jackbackrack/socialbadge-ai/designs/socialbadge_ai.designs.badge_main.BadgeDesign/kicad/3d-models/jitx-64d1493ab789d8dc4b7b3f0a.stp

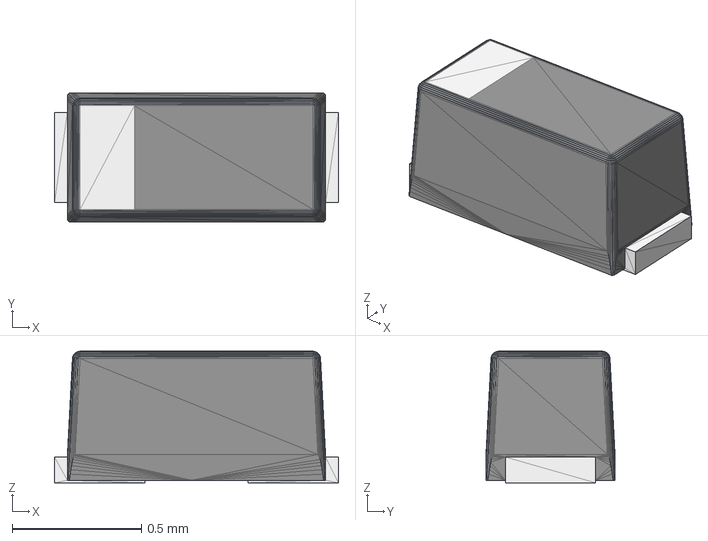
[picture p1: CAD file, 2026-09-09, last stored version]
designs/socialbadge_ai.designs.badge_main.BadgeDesign/kicad/3d-models/jitx-64d1493ab789d8dc4b7b3f0a.stp
1.10 x 0.5 x 0.51 mm
