jackbackrack/socialbadge-ai/designs/socialbadge_ai.designs.badge_main.BadgeDesign/kicad/3d-models/jitx-64d13eb0b789d8dc4b79e9c7.stp

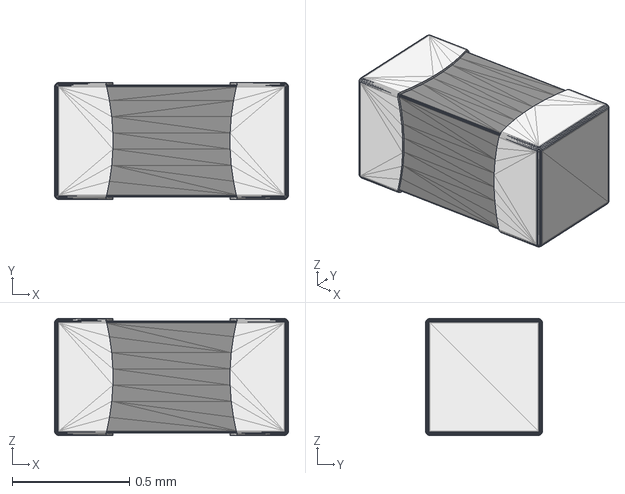
[picture p2: CAD file, 2026-09-09, last stored version]
designs/socialbadge_ai.designs.badge_main.BadgeDesign/kicad/3d-models/jitx-64d13eb0b789d8dc4b79e9c7.stp
1.00 x 0.5 x 0.5 mm
