jackbackrack/socialbadge-ai/designs/socialbadge_ai.designs.badge_main.BadgeDesign/kicad/socialbadge_ai.designs.badge_main.BadgeDesign.kicad_pcb

## KiCad design designs/socialbadge_ai.designs.badge_main.BadgeDesign/kicad/socialbadge_ai.designs.badge_main.BadgeDesign.kicad_pcb (2026-09-11, last stored version)

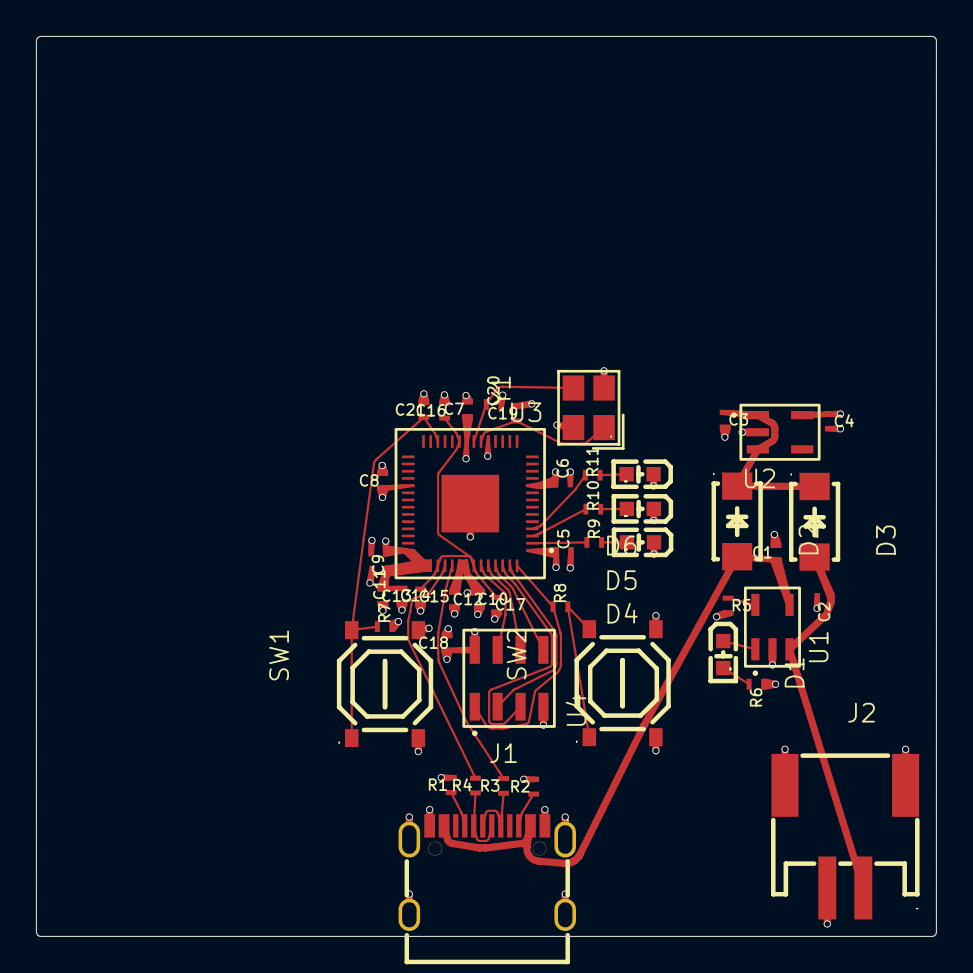
[picture p3: board socialbadge_ai.designs.badge_main.BadgeDesign.kicad_pcb from above]

Board: 4 copper layers, 50.0 x 50.0 mm, 47 parts (0 on the bottom side), 31 nets.

Parts:
C1: 4.7 µF; LANDPATTERN0402_4
C2: 4.7 µF; LANDPATTERN0402_5
C3: 1 µF; LANDPATTERN0402_8
C4: 1 µF; LANDPATTERN0402_9
C5: 100 nF; LANDPATTERN0402_10
C6: 100 nF; LANDPATTERN0402_11
C7: 100 nF; LANDPATTERN0402_12
C8: 100 nF; LANDPATTERN0402_13
C9: 100 nF; LANDPATTERN0402_14
C10: 100 nF; LANDPATTERN0402_15
C11: 100 nF; LANDPATTERN0402_16
C12: 100 nF; LANDPATTERN0402_17
C13: 1 µF; LANDPATTERN0402_18
C14: 100 nF; LANDPATTERN0402_19
C15: 1 µF; LANDPATTERN0402_20
C16: 100 nF; LANDPATTERN0402_21
C17: 100 nF; LANDPATTERN0402_22
C18: 100 nF; LANDPATTERN0402_23
C19: 27 pF; LANDPATTERN0402_24
C20: 27 pF; LANDPATTERN0402_25
C21: 100 nF; LANDPATTERN0402_27
D1: KT-0603R; Pkg_LP_1
D2: SS14; Pkg_LP_2
D3: SS14; Pkg_LP_3
D4: KT-0603R; Pkg_LP_7
D5: KT-0603R; Pkg_LP_8
D6: KT-0603R; Pkg_LP_9
J1: TYPE-C-31-M-12; Pkg_LP
J2: 2.0-2P WT; Pkg_LP_10
R1: 5.1 kΩ; LANDPATTERN0402
R2: 5.1 kΩ; LANDPATTERN0402_1
R3: 27 Ω; LANDPATTERN0402_2
R4: 27 Ω; LANDPATTERN0402_3
R5: 2 kΩ; LANDPATTERN0402_6
R6: 1 kΩ; LANDPATTERN0402_7
R7: 10 kΩ; LANDPATTERN0402_26
R8: 1 kΩ; LANDPATTERN0402_28
R9: 330 Ω; LANDPATTERN0402_29
R10: 330 Ω; LANDPATTERN0402_30
R11: 330 Ω; LANDPATTERN0402_31
SW1: TS-1187A-B-A-B; Pkg_LP_5
SW2: TS-1187A-B-A-B; Pkg_LP_6
U1: MCP73831T-2ACI/OT; SOT23_5
U2: AP2112K-3.3TRG1; SOT23_5_1
U3: RP2040; QFN
U4: W25Q128JVSIQ; SOIC
Y1: X322512MSB4SI; Pkg_LP_4

Connections:
1V1: C15.1, C16.1, C17.1, U3.23, U3.45, U3.50
3V3: C4.1, C5.1, C6.1, C7.1, C8.1, C9.1, C10.1, C11.1, C12.1, C13.1, C14.1, C18.1, R6.1, R7.2, U2.5, U3.1, U3.10, U3.22, U3.33, U3.42, U3.43, U3.44, U3.48, U3.49, U4.8
BOOTSEL_NODE: R8.2, SW2.1, SW2.2
CHG_STAT: D1.1, U1.1
GND: C1.2, C2.2, C3.2, C4.2, C5.2, C6.2, C7.2, C8.2, C9.2, C10.2, C11.2, C12.2, C13.2, C14.2, C15.2, C16.2, C17.2, C18.2, C19.2, C20.2, C21.2, D4.1, D5.1, D6.1, J1.9, J1.10, J1.13, J1.14, J1.15, J1.16, J2.2, J2.3, J2.4, R1.2, R2.2, R5.2, SW1.3, SW1.4, SW2.3, SW2.4, U1.2, U2.2, U3.19, U3.thermal_pads0, U4.4, Y1.2, Y1.3
GPIO[0]: R9.1, U3.2
GPIO[1]: R10.1, U3.3
GPIO[2]: R11.1, U3.4
PROG: R5.1, U1.5
QSPI_CSn: R8.1, U3.56, U4.1
QSPI_SCLK: U3.52, U4.6
QSPI_SD0: U3.53, U4.5
QSPI_SD1: U3.55, U4.2
QSPI_SD2: U3.54, U4.3
QSPI_SD3: U3.51, U4.7
RUN: C21.1, R7.1, SW1.1, SW1.2, U3.26
SYS: C3.1, D2.2, D3.2, U2.1, U2.3
USB_DM: R4.2, U3.46
USB_DN: J1.3, J1.5, R4.1
USB_DP: J1.4, J1.6, R3.1
VBAT: C2.1, D3.1, J2.1, U1.3
VBUS: C1.1, D2.1, J1.11, J1.12, U1.4
XIN: C19.1, U3.20, Y1.1
XOUT: C20.1, U3.21, Y1.4
mcu_USB_DP: R3.2, U3.47
p1: J1.8, R2.1
p2: D1.2, R6.2
r_cc1_p1: J1.2, R1.1
r_leds[0]_p2: D4.2, R9.2
r_leds[1]_p2: D5.2, R10.2
r_leds[2]_p2: D6.2, R11.2
