jackbackrack/socialbadge-ai/src/socialbadge_ai/designs/badge_main.py

"""
SocialBadge AI — top-level design.

40 × 40 mm square board with 0.25 mm rounded corners on the JLCPCB 4-layer FR-4
1080-prepreg stackup (JLC04161H_1080). Combines the USB-C interface, Li-ion
charger, Schottky power-path, 3.3 V LDO, and RP2040 support circuits into a
single buildable design.

Power tree (already documented in ARCHITECTURE.md):

  USB-C VBUS -+---[ SS14 ]--+
              |              SYS --[ AP2112K-3.3 ]--> 3V3 --> RP2040 + flash
              +--[ MCP73831 ]--> VBAT --[ SS14 ]--+
                                ^
                            JST-PH battery

Design rules and passive defaults are tuned for the JLCPCB Standard 4-layer fab class.
"""

import os

from jitx import Circuit, Design, Net, Pour
from jitx.board import Board
from jitx.constraints import (
    BinaryDesignConstraint,
    IsCopper,
    IsPad,
    IsTrace,
    Tag,
    UnaryDesignConstraint,
)
from jitx.shapes.composites import rectangle
from jitxlib.jlcpcb import JLC04161H_1080
from jitxlib.landpatterns.ipc import DensityLevel, DensityLevelContext
from jitxlib.parts import CapacitorQuery, Minimize, ResistorQuery
from jitxlib.symbols.net_symbols import GroundSymbol, PowerSymbol

from ..circuits.charger import Charger
from ..circuits.ldo_3v3 import LDO_3V3
from ..circuits.power_path import PowerPath
from ..circuits.rp2040_support import RP2040Support
from ..circuits.status_leds import N_LEDS, StatusLEDs
from ..circuits.usb_c import USB_C
from jitx_warp_integration.layout_placements import layout_placements

from ..components.connectors.shouhan_PH2_2P import PH2_2P

# Tags applied to nets so the design rules can match them by class.
class PowerTag(Tag):
    """Marks power rails for the wider-trace rule."""


class GroundTag(Tag):
    """Marks ground nets for the wider-trace rule."""


# Board outline — 40.0 × 40.0 mm with 0.25 mm rounded corners.
BOARD_SHAPE = rectangle(40.0, 40.0, radius=0.25)


class BadgeBoard(Board):
    """40.0 × 40.0 mm board with 0.25 mm rounded corners."""

    shape = BOARD_SHAPE


class BadgeCircuit(Circuit):
    """Top-level netlist for the badge.

    Instantiates all five subcircuits, wires up the power tree, ties USB-C data
    lines and SWD to the RP2040, and exposes pours on inner GND/Power planes.
    """

    def __init__(self):
        # --- Nets ---
        self.GND = Net(name="GND", symbol=GroundSymbol())
        self.VBUS = Net(name="VBUS", symbol=PowerSymbol())
        self.VBAT = Net(name="VBAT", symbol=PowerSymbol())
        self.SYS = Net(name="SYS", symbol=PowerSymbol())
        self.V3V3 = Net(name="3V3", symbol=PowerSymbol())

        GroundTag().assign(self.GND)
        PowerTag().assign(self.VBUS)
        PowerTag().assign(self.VBAT)
        PowerTag().assign(self.SYS)
        PowerTag().assign(self.V3V3)

        # --- Subcircuits ---
        self.usb = USB_C()
        self.charger = Charger()
        self.path = PowerPath()
        self.ldo = LDO_3V3()
        self.mcu = RP2040Support()
        self.status = StatusLEDs()

        # Battery connector — MOUNT tabs tie to GND
        self.battery = PH2_2P()

        # --- Power tree ---
        # USB-C VBUS → charger input, power-path VBUS input
        self.VBUS += self.usb.vbus.Vp + self.charger.vbus.Vp + self.path.vbus.Vp
        # Charger output → battery (BAT positive) and power-path VBAT input
        self.VBAT += (
            self.charger.vbat.Vp
            + self.path.vbat.Vp
            + self.battery.PIN1
        )
        # Power-path output → LDO input
        self.SYS += self.path.sys.Vp + self.ldo.vin.Vp
        # LDO output → MCU 3V3 + charger LED pull-up
        self.V3V3 += self.ldo.vout.Vp + self.mcu.v3v3.Vp + self.charger.v3v3.Vp

        # GND across everything
        self.GND += (
            self.usb.vbus.Vn
            + self.charger.vbus.Vn
            + self.charger.vbat.Vn
            + self.charger.v3v3.Vn
            + self.path.vbus.Vn
            + self.path.vbat.Vn
            + self.path.sys.Vn
            + self.ldo.vin.Vn
            + self.ldo.vout.Vn
            + self.mcu.v3v3.Vn
            + self.status.gnd
            + self.battery.PIN2
            + self.battery.MOUNT1
            + self.battery.MOUNT2
        )

        # --- USB data lines: USB-C circuit ↔ RP2040 support ---
        self.usb_dp_link = [self.usb.DP + self.mcu.usb_dp]
        self.usb_dn_link = [self.usb.DN + self.mcu.usb_dn]

        # --- Status LEDs driven by GPIO[0..2] (active-high) ---
        self.status_led_drive = [
            self.mcu.gpio[i] + self.status.gpio[i] for i in range(N_LEDS)
        ]

        # --- Pours.
        # Stackup is SIG / GND / PWR / SIG — inner layer 1 is a solid GND
        # reference plane and inner layer 2 is the 3V3 power plane. The two
        # outer signal layers (0, 3) get GND fills in unrouted areas.
        # Assigned as circuit attributes (not just `net += Pour(...)`), so each
        # pour is also "strongly" owned by the circuit rather than only
        # reachable via the net — the latter is deprecated (and, separately,
        # invisible to structural traversal like `visit()`/`query()`, which
        # the reverse-flow design-report script relies on to enumerate pours).
        self.gnd_pour_l0 = Pour(BOARD_SHAPE, layer=0, isolate=0.25, rank=1)
        self.gnd_pour_l1 = Pour(BOARD_SHAPE, layer=1, isolate=0.25, rank=1)
        self.v3v3_pour_l2 = Pour(BOARD_SHAPE, layer=2, isolate=0.25, rank=1)
        self.gnd_pour_l3 = Pour(BOARD_SHAPE, layer=3, isolate=0.25, rank=1)
        self.GND += self.gnd_pour_l0
        self.GND += self.gnd_pour_l1
        self.GND += self.gnd_pour_l3
        self.V3V3 += self.v3v3_pour_l2


class BadgeDesign(Design):
    """Buildable design entry point.

    Run: `python -m jitx build socialbadge_ai.designs.badge_main.BadgeDesign`
    """

    board = BadgeBoard()
    substrate = JLC04161H_1080()

    # SMT production defaults — JLCPCB full assembly, ceramic decoupling.
    # rank=Minimize("case") prefers the smallest available case (0402) and
    # only falls back to 0603/0805 when 0402 isn't stocked for that value —
    # otherwise the live JLCPCB catalog query can non-deterministically pick
    # a larger case with no preference set.
    capacitor_defaults = CapacitorQuery(
        case=["0402", "0603", "0805"],
        rank=Minimize("case"),
    )
    resistor_defaults = ResistorQuery(
        case=["0402", "0603", "0805"],
        rank=Minimize("case"),
    )

    circuit = BadgeCircuit()

    def __init__(self):
        # Pin the IPC density level explicitly: jitxlib-standard 4.5.0a1
        # defaults to B (median keepout), where this design was tuned for
        # the older C (least/tightest) default — pin it rather than drift
        # with whatever a future library version defaults to.
        DensityLevelContext(DensityLevel.C).set()

        # Production-friendly defaults calibrated to JLC 4-layer 1080
        # (minimum trace width / clearance 0.0889 mm / 3.5 mil per JLC standard rules).
        self.rules = [
            UnaryDesignConstraint(IsTrace).trace_width(0.125),
            BinaryDesignConstraint(IsCopper, IsCopper).clearance(0.125),
            UnaryDesignConstraint(IsPad).thermal_relief(0.125, 0.2, 4),
            UnaryDesignConstraint(
                PowerTag() | GroundTag(), priority=1
            ).trace_width(0.4),
        ]
        # apply_board_shape=False: jitx_export.json still has the captured
        # 30mm-era board shape, which would otherwise silently override the
        # 40mm BOARD_SHAPE above on every build. Component placements from
        # the file are still replayed.
        #
        # Skipped when WARP_LIVE=1: a live warp session pushes placements
        # directly through rd.layout, and the runtime rejects place() on
        # anything already placed in code.
        if os.environ.get("WARP_LIVE") != "1":
            layout_placements("jitx_export.json", apply_board_shape=False)
