jackbackrack/socialbadge-ai/src/socialbadge_ai/circuits/ldo_3v3.py

"""
3.3 V LDO subcircuit — Diodes AP2112K-3.3 with input/output decoupling.

Always-enabled: EN tied to VIN. Per AP2112 datasheet figure 2: 1 uF X5R/X7R on each
of input and output is stable across the operating range.
"""

from jitx import Circuit, Net
from jitx.common import Power
from jitx.net import ShortTrace
from jitx.units import F, V
from jitxlib.parts import Capacitor

from ..components.power_linear_regulators.diodes_AP2112K_33TRG1 import AP2112K_33TRG1
from ..components.test_points.test_point import TestPoint


class LDO_3V3(Circuit):
    """Steps SYS rail (3.0-5.5 V) down to a regulated 3.3 V output, 600 mA capable."""

    vin = Power()    # input — connect to SYS rail
    vout = Power()   # output — 3.3 V

    def __init__(self):
        self.GND = Net(name="GND")
        self.VIN = Net(name="VIN_LDO")
        self.V3V3 = Net(name="3V3")

        self.u1 = AP2112K_33TRG1()

        self.GND += self.vin.Vn + self.vout.Vn + self.u1.GND
        self.VIN += self.vin.Vp + self.u1.VIN + self.u1.EN  # EN tied to VIN
        self.V3V3 += self.vout.Vp + self.u1.VOUT

        self.c_in = Capacitor(capacitance=1.0e-6 * F, rated_voltage_dc=10.0 * V, temperature_coefficient_code="X5R")
        self.c_in_nets = [
            ShortTrace(self.c_in.p1, self.u1.VIN),
            self.c_in.p2 + self.u1.GND,
        ]

        self.c_out = Capacitor(capacitance=1.0e-6 * F, rated_voltage_dc=10.0 * V, temperature_coefficient_code="X5R")
        self.c_out_nets = [
            ShortTrace(self.c_out.p1, self.u1.VOUT),
            self.c_out.p2 + self.u1.GND,
        ]

        # Bring-up test point — LDO's regulated 3V3 output.
        self.tp_v3v3 = TestPoint()
        self.tp_v3v3_net = ShortTrace(self.tp_v3v3.p1, self.u1.VOUT)


Device = LDO_3V3
