jackbackrack/socialbadge-ai/src/socialbadge_ai/circuits/status_leds.py

"""
3× GPIO-driven red status LEDs (Hubei KENTO KT-0603R).

Active-high drive: GPIO → 330 Ω → LED anode → LED cathode → GND.
At 3.3 V GPIO and ~1.9 V V_F the LED current is about 4 mA, matching the RP2040's
default GPIO drive strength.

KT-0603R (LCSC C2286) is a JLCPCB Basic part — same model as the charge-status LED.

External ports:
- gnd       : board GND
- gpio[0..2]: three GPIO drive lines from the MCU
"""

from jitx import Circuit, Net
from jitx.net import Port
from jitx.units import ohm
from jitxlib.parts import Resistor

from ..components.diodes.kt_0603_red import KT_0603R
from ..components.test_points.test_point import TestPoint


N_LEDS = 3
LED_DRIVE_RESISTOR_OHMS = 330.0  # (3.3 - 1.9 V) / 4 mA ≈ 350 Ω → 330 Ω E-series


class StatusLEDs(Circuit):
    """Three active-high red status LEDs with 330 Ω current-limit resistors."""

    gnd = Port()
    gpio = [Port() for _ in range(N_LEDS)]

    def __init__(self):
        self.GND = Net(name="GND")
        self.GND += self.gnd

        self.leds = [KT_0603R() for _ in range(N_LEDS)]
        self.r_leds = [Resistor(resistance=LED_DRIVE_RESISTOR_OHMS * ohm) for _ in range(N_LEDS)]

        # For each LED: GPIO -> R -> LED anode -> LED cathode -> GND
        self.cathode_nets = [self.leds[i].K + self.GND for i in range(N_LEDS)]
        self.drive_nets = [
            net
            for i in range(N_LEDS)
            for net in (
                self.r_leds[i].p1 + self.gpio[i],
                self.r_leds[i].p2 + self.leds[i].A,
            )
        ]

        # Bring-up test point — GND reference near the LED cluster.
        # No ShortTrace/via needed: GND has a pour on this same layer
        # (layer 0) spanning the whole board, so a GND-net pad connects
        # directly wherever it sits, no copper object required.
        self.tp_gnd = TestPoint()
        self.GND += self.tp_gnd.p1


Device = StatusLEDs
