jackbackrack/socialbadge-ai/(commit log)

2026-09-09 Initial commit: Social Badge AI JITX hardware design
    USB-C powered badge board built on jitx 4.4 / jitxlib-standard 4.4:
    RP2040 MCU, MCP73831 Li-ion charger, AP2112K 3.3V LDO, W25Q128 flash,
    status LED and tactile button, JST-PH battery connector.
    Includes sourced datasheets, KiCad-converted footprints, parts-db
    lookups, and PLAN.md/ARCHITECTURE.md design docs. Build/runtime
    artifacts (.jitx/, designs/, .socket.jitx, dependency cache) are
    gitignored as regenerable output.
    [jitx-64d13eb0b789d8dc4b79e9c7.stp, jitx-64d1493ab789d8dc4b7b3f0a.stp]
2026-09-10 Fix .gitignore to stop excluding src/socialbadge_ai/designs/
    The unanchored "designs/" pattern matched any directory named "designs"
    anywhere in the tree, not just the intended root-level build-output
    directory — so it silently excluded src/socialbadge_ai/designs/, which
    contains badge_main.py, the top-level BadgeDesign entry point. Anchor
    the pattern to the repo root ("/designs/") and add the missing files.
    [badge_main.py]
2026-09-11 add designs
    [jitx-64d13eb0b789d8dc4b79e9c7.stp, jitx-64d1493ab789d8dc4b7b3f0a.stp, socialbadge_ai.designs.badge_main.BadgeDesign-2.kicad_sch, socialbadge_ai.designs.badge_main.BadgeDesign-3.kicad_sch, socialbadge_ai.designs.badge_main.BadgeDesign.kicad_pcb, socialbadge_ai.designs.badge_main.BadgeDesign.kicad_sch]
2026-09-11 remove kicad
    [jitx-64d13eb0b789d8dc4b79e9c7.stp, jitx-64d1493ab789d8dc4b7b3f0a.stp, socialbadge_ai.designs.badge_main.BadgeDesign-2.kicad_sch, socialbadge_ai.designs.badge_main.BadgeDesign-3.kicad_sch, socialbadge_ai.designs.badge_main.BadgeDesign.kicad_pcb, socialbadge_ai.designs.badge_main.BadgeDesign.kicad_sch]
2026-09-25 Add reverse-flow design-report script and layout-placement support
    - scripts/design_report.py: per-component/per-net reverse-flow report
    (placements, pads, courtyards, nets, shorts, vias, modules), ported
    from internal-test-designs' plugin so it runs in this project's own
    venv against its own jitx/jitxlib versions instead of depending on
    that other project's venv staying in sync.
    - src/socialbadge_ai/designs/layout_placements.py: round-trips board
    shape and component placements through a JSON layout file via
    Circuit.place(), called from BadgeDesign.__init__.
    - badge_main.py: wire up layout_placements(), pin IPC density level to
    C explicitly (library default drifted to B), and r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
    [badge_main.py, charger.py, ldo_3v3.py, rp2040_support.py, status_leds.py, usb_c.py]
2026-09-25 Fix W25Q128JVEIQ courtyard: pin density level C explicitly
    landpattern is a class attribute evaluated at import time, before
    BadgeDesign.__init__ sets its ambient DensityLevelContext(C) — so that
    context can never reach a hand-authored component's generator chain.
    The flash still had density_level(B) copy-pasted from the earlier SOIC
    variant, giving a looser courtyard (toe 0.3mm / courtyard_excess
    0.25mm) than the rest of the design. Set C explicitly instead, matching
    the existing convention in raspberry_pi_RP2040.py. Courtyard shrinks
    from 7.4x8.5mm to 6.9x8.1mm, closer to the 6.00x8.00mm body.
2026-09-25 Fix W25Q128JVEIQ courtyard: swap D/E axis mapping to match real footprint
    Ground-truthed against LCSC's KiCad footprint for C2456297: the 4-pad
    rows run along the 6mm (E) edge and are separated across the 8mm (D)
    edge, opposite of what was assumed. Courtyard now hugs the body/pads
    correctly instead of leaving ~1.9mm of empty margin per side.
2026-09-26 Add lcsc.lock.json with corrected JLCPCB assembly orientations
    Pins the CPL rotation corrections for every LCSC-sourced part. Notably
    fixes SS14 (C2480) and KT-0603R (C2286): both are 2-pin, 180-degree-
    symmetric footprints where geometry alone can't set the orientation,
    so the exporter fell back to matching pad number labels. Since those
    landpatterns number their pads opposite the real catalogue part, that
    fallback silently paired anode with cathode, orientation 180 instead
    of the correct 0 - every diode and LED would have been assembled
    backwards.
2026-09-26 Add LCSCPart() to all fixed-value components, pin JLCPCB orientations
    Attaches LCSC part numbers to every fixed component that lacked one
    (connectors, RP2040, charger, LDO, button, diode, LED, crystal), for
    JLCPCB BOM/CPL sourcing. Also pins explicit LCSCPart(orientation=...)
    on the parts where auto-measurement was wrong or unreliable:
    - Flash (C2456297): auto-measured 265 deg, snapped to the correct 270.
    - MCP73831 (C424093) and AP2112K (C51118): verified pin-for-pin against
    the real footprint at 270 deg.
    - SS14 (C2480) and KT-0603R (C2286): these landpatterns number their
    pads opposite the real catalogue parts, so the exporter's pad-label
    fallback paired anode with cathod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
    [raspberry_pi_RP2040.py]
2026-09-28 Sync design_report.py with agility's copper-pours support; fix pour ownership
    Adopts agility-fourty-jitx's updates to the shared design_report.py:
    adds a top-level "pours" list (id/net/layer/rank/isolate/shape/extent),
    a jitx 4.4/4.5 nets()/layers() method-vs-property compat shim, and
    ruff formatting.
    Testing the pour branch against this design (which agility's own
    design has none of) surfaced a real gap: `design.query(Pour)` only
    finds pours reachable via normal circuit ownership, and this design's
    4 board-plane pours were attached only via `net += Pour(...)`, a
    pattern jitx already deprecates for exactly this reason (logged as
    "not assigned to a circuit"). Fixed by also assigning each pou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
    [badge_main.py]
2026-09-28 Sync design_report.py: net-only pour discovery, "owned" field
    Adopts agility-fourty-jitx's follow-up: pours attached only via
    `net += Pour(...)` (never assigned to a circuit attribute) are now
    discovered through a scan of every net's connections, not just
    design.query(Pour). Each pour gains an "owned" bool; net-only pours
    get an id derived from the net's path and are tagged [NET-ONLY] in
    the .txt report.
    Verified end-to-end against this design by temporarily reverting one
    pour back to net-only attachment: it's correctly reported with
    owned=false and the right net/layer/extent, and the warning-triggering
    pattern this was built for reappears as expected. Our actual 4 pours
    (all circuit-owned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
2026-09-28 Sync design_report.py: declared vs. captured placement tracking
    Adopts agility-fourty-jitx's declared_placements()/"moved_from_declared"
    addition: reads each component's pre-capture transform (set by `.at(...)`)
    and compares it against the post-capture layout, flagging components an
    editor session has moved since the design code placed them.
    Verified it runs cleanly against this design, but it can't do anything
    useful here: every one of our 47 components is placed via
    Circuit.place() (through layout_placements.py), not `.at(...)`, and
    Circuit.place() only queues a placement request server-side -- it never
    sets .transform locally, confirmed directly (comp.transform is None for
    all 47 compone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
2026-09-28 Sync design_report.py: rename to "fixed", add explicit code-placed flag
    Adopts agility-fourty-jitx's rename (code_placed_components ->
    fixed_components) and new per-component "fixed" bool: true only when
    the design code set a transform via .at(...). Confirms our finding
    from the last sync -- every component here reports fixed=false, since
    this design places everything via Circuit.place() rather than .at(...),
    which never sets a local transform for this API to see.
2026-09-28 Sync design_report.py: Circuit.place() now counted as a fixed placement
    declared_placements() resolves InstancePlacement requests (Circuit.place)
    in addition to .at(...), including relative_to chains, and reports
    "placed_by": "at" | "place" per component.
    This was the real fix for what my last two syncs flagged as fixed=false
    on every component here -- this design places all 47 components via
    Circuit.place() through layout_placements.py, never .at(...). Verified
    against badge_main.BadgeDesign: 47/47 fixed_components, every
    placed_by "place", 0 moved_from_declared, and declared_placement matches
    placement exactly (numerically identical center/angle) for every
    component checked -- confirms th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
2026-09-28 Sync design_report.py: fixed/relative/free placement classification
    Adopts agility-fourty-jitx's rework of declared_placements() per their
    user's rule: only a global .at() is "fixed" (design intent to hold); a
    relative_to placement or .at() inside a floating circuit is "relative"
    (rigid offset, lock together); a Circuit.place() with no anchor -- a
    replayed layout file, as ours are -- is neither, free to move. Modules
    now also carry "relative"/"floating".
    Verified against badge_main.BadgeDesign, matching their prediction
    exactly: fixed_components 0, relative_components 0, all 47 placed_by
    "place", 0 moved_from_declared, poses still numerically identical
    between "placement" and "declared_plac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
2026-09-29 Sync design_report.py: export JITX tags and design rules
    Adopts agility-fourty-jitx's tags/design_rules export: per-object
    "tags" (component, landpattern, pad, via, pour, net, module), a
    top-level "tag_types" hierarchy (parents/doc/builtin), and top-level
    "design_rules" (id/name/priority/kind/conditions/condition_trees/
    effects) from every DesignConstraint.
    Verified against badge_main.BadgeDesign, which has real custom tags
    and rules to exercise (unlike Forty, which has none):
    - All 5 tagged nets correct: 3V3/SYS/VBAT/VBUS -> PowerTag,
    GND -> GroundTag, matching the design's own PowerTag().assign(...)
    calls exactly.
    - All 4 design rules captured correctly, including the OR-condi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
2026-09-29 Sync design_report.py: resolve per-net trace width and clearance
    Adopts agility-fourty-jitx's rule resolution: top-level "rules"
    (resolved defaults plus substrate fab minimums), per-net "trace_width"/
    "clearance" (null = use the default), "net_clearances" for pair-
    dependent clearance rules, and routing-structure overrides.
    Verified in full against badge_main.BadgeDesign's real rules:
    - rules.trace_width=0.125 (from the IsTrace rule), .clearance=0.125
    (from the IsCopper/IsCopper rule) -- both correctly attributed by
    "sources".
    - The 5 PowerTag/GroundTag nets (3V3/SYS/VBAT/VBUS/GND) each resolve
    trace_width=0.4, correctly winning over the base 0.125 rule via
    priority (1 >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
2026-09-29 Untrack build caches, backup files, and lcsc.lock.json
    Removes designs/*/cache/* and design-info/*.backup-N from tracking --
    regenerable build output that only ever produced repo-status noise
    (they were already excluded for new files by the existing /designs/
    .gitignore rule, just never removed once tracked). Keeps the
    meaningful design-info files (physical-layout.design,
    reference-designators.table, schematic.design, stable.design).
    Also untracks lcsc.lock.json and adds it to .gitignore: a fresh build
    should regenerate it from scratch, not depend on a checked-in copy.
    Verified this is safe for the orientation fixes made earlier this
    session -- ran a full export with no lock file present at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
2026-09-29 Add route sketch round-trip to layout_placements.py
    Represents jitx's Route.Sketch concept (a hint path for the routing
    engine: start/turns/end points, not a resolved copper trace) in the
    same JSON layout file used for placements, so an external layout tool
    can hand JITX a manually-drawn route path.
    New "routes" list, alongside the existing "components": each entry is
    {"source", "destination", "layer", "sketch"}, source/destination being
    paths to a Port or Pad (same path format as a component's "id"),
    coordinates in absolute board mm like everything else in the file.
    sketch may also be a bare list of >=2 points, or omitted for a route
    with no path hint.
    Import: resolves source/destination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
2026-09-29 Add resolved-route export; report pours as declared, not computed
    Two additions to the reverse-flow design report:
    1. New top-level "routes": every real Route the router (interactive or
    auto) has already produced -- reverse-flow synthesizes one per
    routed segment once the design is captured, complete with a
    resolved sketch and the actual copper (route.traces). Distinct from
    the route *sketch* concept added to layout_placements.py earlier
    (a hint for JITX's router to consume, not something JITX already
    routed) -- this is the other direction, surfacing what's already
    there. Each entry: id, net, layer, source/destination (kind +
    path -- pad, via, or port), sketch, shape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
2026-09-29 Drop route "shape"/"extent": sketch turns are enough for a consumer
    A route's "shape" was the actual filled-copper outline (width-expanded,
    rounded joints) -- real geometry, but a consumer that reconstructs its
    own trace from the centerline (start/turns/end) doesn't need it, and
    it was the single biggest contributor to file size (roughly half of
    it, for this design's 115 routes). Each route entry is now just
    id/net/layer/source/destination/sketch.
2026-09-30 Add stackup export: every conductor layer's side/material/thickness
    New top-level "stackup": [{"layer", "side": "top"|"inner"|"bottom",
    "name", "material", "thickness"}], one entry per conductor, indices
    matching the "layer" field used everywhere else (pads, vias, pours,
    routes). Lets a router know what layer indices actually exist instead
    of just a bare count.
    jitx's Conductor/Stackup classes have no signal-vs-plane distinction --
    that's a per-design usage convention, not a stackup property -- so
    this doesn't attempt to guess one; a consumer wanting that should
    cross-reference which layers this report's pours/routes actually land
    on. Verified against badge_main.BadgeDesign's real JLC04161H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
2026-09-30 Sync design_report.py: stackup material falls back to class name
    Adopts agility-fourty-jitx's fix: a Conductor without an explicit
    material_name (per jitx's own docs, "the name of the class is used")
    now falls back to Proxy.type(conductor).__name__ instead of reporting
    null. Verified this design's own conductors are unaffected (all four
    already set material_name via jitxlib-jlcpcb's Copper1oz/CopperHalfOz).
    Also cleaned up two things they flagged: a redundant local `from
    jitx.copper import Pour` in declared_pour_shapes (already imported at
    module level), and expanded the route "sketch" docstring to note it
    reads a private accessor (route.sketch._points(), no public one exists)
    on top of the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
2026-09-30 Add per-layer route/pour counts to stackup, for signal-vs-plane inference
    Each stackup entry now also reports "routes" (count on that layer),
    "pours" (count), and "full_board_pour" (whether any of those pours
    covers ~the whole board -- a plane-shaped fill vs. a smaller keepout).
    Cheap: routes/pours are already collected by the time stackup is built.
    Deliberately still not a single verdict: this design's own layer 0 has
    ALL 115 routes AND a full-board GND pour (routed signals with a ground
    fill in the gaps, a completely normal, common layer use) -- a naive
    "has a plane-sized pour -> plane" rule would misclassify it. Raw counts
    let a consumer apply whatever threshold suits it (e.g. "most rout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
2026-10-02 Add via fixed/placed_by, via_definitions, and layout-file via import
    From eink-placard-f1/power-distribution (synced in this round, after
    finding and reporting two real bugs that got fixed before I'd accept
    them):
    design_report.py: each via now reports "fixed"/"placed_by" (true/"at"
    only if the design code itself declared it, via a pre-capture
    declared_vias() snapshot -- a captured transform alone doesn't mean
    code placed it, since reverse-flow/router-synthesized vias get one
    too). New top-level "via_definitions": every via type the substrate
    declares plus any the design uses, with pad/drill diameter and layer
    span. summary gets "fixed_vias"/"via_definitions".
    layout_placements.py: _write_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
2026-10-05 Export keepouts and per-component silkscreen
    New top-level "keepouts": every KeepOut feature in the design, absolute
    board coordinates (id, layers as normalized {start, end} ranges,
    pour/via/route bools, shape, extent). This design declares none, so
    it's an empty list here -- verified no crash either way.
    New per-component "silkscreen": every Silkscreen feature baked into
    that component's landpattern (reference designator text, pin-1
    markers, outlines), in COMPONENT-LOCAL coordinates like "pads" and
    "courtyard" already are, not absolute board coordinates -- so a
    consumer that moves/rotates a component can apply that same transform
    to its silkscreen without looking anything up again. Verifie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
2026-10-05 Export board-level silkscreen, separate from per-component silkscreen
    New top-level "board_silkscreen": Silkscreen features declared directly
    on the board/circuit (a logo, a label, manual artwork) rather than
    baked into any component's landpattern -- a logo or board label isn't
    attached to anything that moves, so unlike per-component "silkscreen"
    (component-local, so it moves with the part), this is in absolute
    board coordinates, the same frame as keepouts/pours/routes, since a
    placer needs to see it fixed in place alongside everything else that is.
    Tracks which Silkscreen objects the per-component walk already
    collected (by id()) and excludes them here, so nothing is double
    counted between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
2026-10-05 Fix pyright narrowing nit in per-component silkscreen (eink-placard)
    Bind t.transform to xf inside the same comprehension that checks it's
    not None, instead of re-reading t.transform in a separate comprehension
    afterward -- the None-check doesn't narrow across that boundary, which
    pyright (strict-ish config) flagged as "*" not supported for "None" at
    the xf * mark.shape call, even though it's unreachable at runtime.
    Behavior unchanged: re-ran against badge_main.BadgeDesign, silkscreen
    count still 183.
2026-10-05 Export actual silkscreen text, not just its bounding box
    Each silkscreen mark (per-component and board-level) that's a Text
    primitive now also gets a "text" field: {"string", "size", "anchor",
    "position", "angle"} in the same frame as that entry's "shape" -- null
    for anything that isn't text. "shape" is unchanged (still the
    discretized bounding box via _shapely_from_shape, for a consumer that
    only wants that), so this is additive.
    The real fix is resolving what .string actually is: reading it
    directly gives a literal ">REF"/">VALUE" placeholder even after
    capture, not the real reference designator or value. jitx's own
    reverse-flow linker computes the real text, applies it, and then
    explicit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
2026-10-05 Add ref_designators import: reposition silkscreen text labels
    New optional "ref_designators" list in the layout JSON: {"id", "position",
    "angle"} per mark, id matching design_report.py's per-component
    "silkscreen[].id". Resolves via the existing parse_refpath mechanism and
    repositions the mark's shape with .at(...) -- the same approach already
    used for routes and vias.
    Initially assumed this wasn't possible: a throwaway, never-before-built
    synthetic design hit "Encountered a deferred instantiable attribute on
    an instantiated object" resolving the same kind of path (reference_designator
    is a class-level declarative field on a landpattern, not an instance
    attribute like a pad or a via). Turns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
2026-10-05 Fix silkscreen id to a true full path; via fixed/relative via shared _frame
    Two fixes from agility's review, plus one eink-placard independently
    caught the same way (the id one):
    1. Per-component silkscreen "id" was component-relative
    ("landpattern._reference_designator"), not resolvable via
    parse_refpath from the design root -- echoing it straight back in a
    ref_designators import entry fails. Fixed: full dotted path via the
    same _child(cid, ...) helper pad refs already use elsewhere in this
    file, e.g. "circuit.mcu.flash.landpattern._reference_designator".
    2. Via "fixed" didn't follow the same rule components do: fixed only
    for a global .at() (no floating/place()-d circui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
2026-10-05 Fix ref_designators import frame and compose-not-replace bug
    mark.shape.at(t) sets transform = t * self.transform (additive), not a
    replacement, so the previous code double-counted the mark's own baked-in
    local offset/rotation. It also treated the absolute board pose as if it
    were already in the landpattern-local frame, which only happened to work
    for an unrotated, top-side part.
    Now each component's board-absolute placement (fixed or layout-placed) is
    captured while processing "components", used to convert a ref designator's
    absolute pose into its owning component's local frame via the inverse
    placement (correctly handling a bottom-side mirror), and the mark's
    pre-existing local transform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
2026-10-05 Fix PIE810 ruff nit: combine startswith() calls into one with a tuple
    Flagged by eink-placard's ruff config after syncing the ref_designators
    frame fix; same pattern existed in design_report.py's _owner(), fixed
    there too for consistency across the shared file.
2026-10-05 Note JITX's confirmation that ref designators are plain silkscreen objects
    Confirms the approach already in use here (direct shape mutation, same
    mechanism Component.at() uses) rather than a workaround around a missing
    facility.
2026-10-06 Move shared design_report.py/layout_placements.py into jitx-design-tools
    Factors the reverse-flow design-report exporter and the layout-file
    import/export round trip out of this project into a standalone package
    (/Users/jrb/jitx-design-tools, installed editable via
    `pip install -e /Users/jrb/jitx-design-tools`), so every sibling jitx
    project consuming the same JSON layout-exchange format shares one
    implementation instead of copy-pasted, independently-drifting forks.
    scripts/design_report.py is now a thin shim importing the package's
    main(), so the existing `python scripts/design_report.py ...` invocation
    is unchanged. badge_main.py imports layout_placements from the package
    directly; the ol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
    [badge_main.py]
2026-10-17 Resize board to 40x40mm, fix stale shape override, add WARP_LIVE switch
    - BOARD_SHAPE bumped 30x30mm -> 40x40mm for easier test-point placement.
    - layout_placements() now passes apply_board_shape=False, since
    jitx_export.json still carries the captured 30mm-era shape and would
    otherwise silently clobber the new one on every build.
    - Skip the layout_placements() replay entirely when WARP_LIVE=1, so a
    live warp session can push placements through rd.layout directly
    instead of fighting code-placed components.
2026-10-21 Add bring-up test points, fix RP2040 thermal-pad paste, adopt jitx-warp-integration
    - New TestPoint component (test_points/): bare SMD pads for multimeter
    probing, wired via ShortTrace onto VBAT, SYS, 3V3 (x2), 1V1, and GND
    (x3) across charger/power_path/ldo_3v3/rp2040_support/status_leds.
    - raspberry_pi_RP2040.py: RP2040's QFN-56 thermal pad now uses a
    segmented paste aperture (SMDPadConfig + WindowSubdivide) instead of
    one solid 3.2x3.2mm block, to reduce solder-bridging risk during
    reflow.
    - charger.py/ldo_3v3.py/rp2040_support.py: removed GND-side ShortTrace
    on existing decoupling caps (plain net join instead) per convention;
    GND already has a full-board pour on the same la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
2026-10-23 Refresh design-info snapshots after upgrading to jitx 4.6.0-rc.3
    Rebuilt against the new runtime (4.6.0-rc.3) and py-jitx
    (4.6.0rc3.dev28+gce431aa66); no source changes, just the regenerated
    stable/schematic/physical-layout snapshots from that rebuild.
2026-10-23 Refresh design-info snapshots after KiCad re-export
    No source changes -- regenerated stable/schematic/physical-layout
    snapshots from rebuilding and re-exporting to KiCad on jitx 4.6.0-rc.3.
2026-10-26 Add USB-C connector build/fab smoke test design
    Centers TYPE_C_31_M_12 on a board sized to its courtyard plus a 1mm
    margin per side, for isolated build and JLCPCB-export testing of the
    connector alone.
2026-10-26 Add minimal repro for JLCPCB misrendering rotated capsule pads
    Two copies of the USB-C connector's mounting-tab slot pad, one at
    -179.99998 deg and one at exactly -180 deg. The off-axis copy exports as
    an aperture macro whose circle primitives rely on the rotation
    parameter, which JLCPCB's viewer ignores (renders as two side-by-side
    circles); the exact copy exports as a plain obround and renders fine.
2026-10-29 Fix USB-C slot pad mask and snap J1 to -180 for 2026-10-26 fab
    TYPE_C_31_M_12's through-hole pads (mounting slots and NC holes) had no
    soldermask openings; add top and bottom openings matching the copper.
    Place J1 at exactly -180 deg instead of -179.99998 so the gerber exporter
    emits standard obround slots rather than a rotated aperture macro, which
    JLCPCB's CAM misreads. test_usb_c rotates the connector by J1's old
    off-axis angle so the macro case stays reproducible.
    This is the state submitted to JLCPCB (jlcpcb-2026-10-27 export).
2026-10-29 Revert Warp layout push of 2026-10-28; refresh design-info snapshots
    Discard the placement, route and via operations Warp appended to
    physical-layout.design over the integration API on 2026-10-28, returning
    the layout to the state fabricated on 2026-10-26. stable.design and
    schematic.design are regenerated from the current code (USB-C slot mask
    fix, J1 at -180); their diff is mostly reordering.
